jpraus/wirebender/stl/bender/Bender_MotorFrame.stl

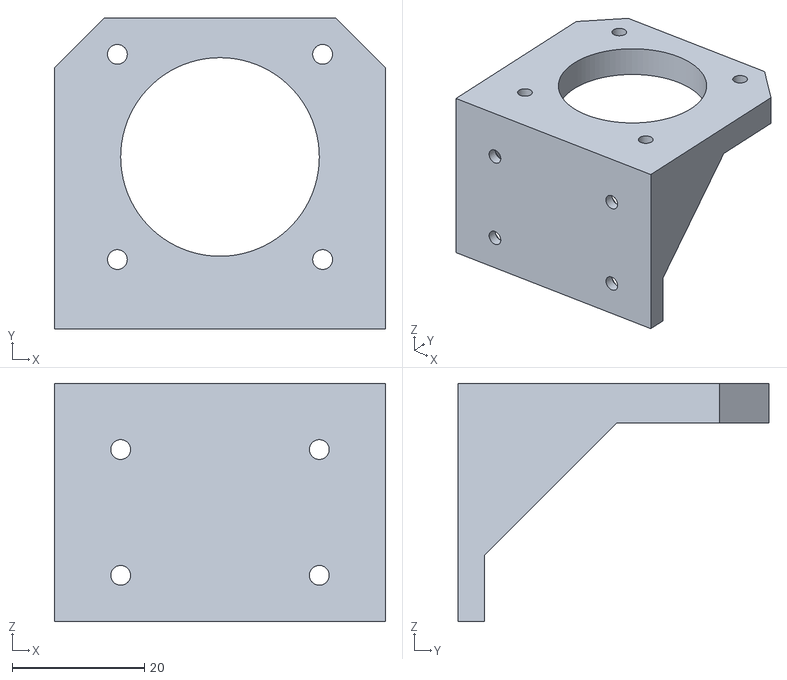
[picture p4: CAD file, 2019-07-29]
stl/bender/Bender_MotorFrame.stl
50.0 x 47.0 x 36.0
