jpraus/wirebender/stl/feeder/Feeder_IdlerGearSpacer.stl

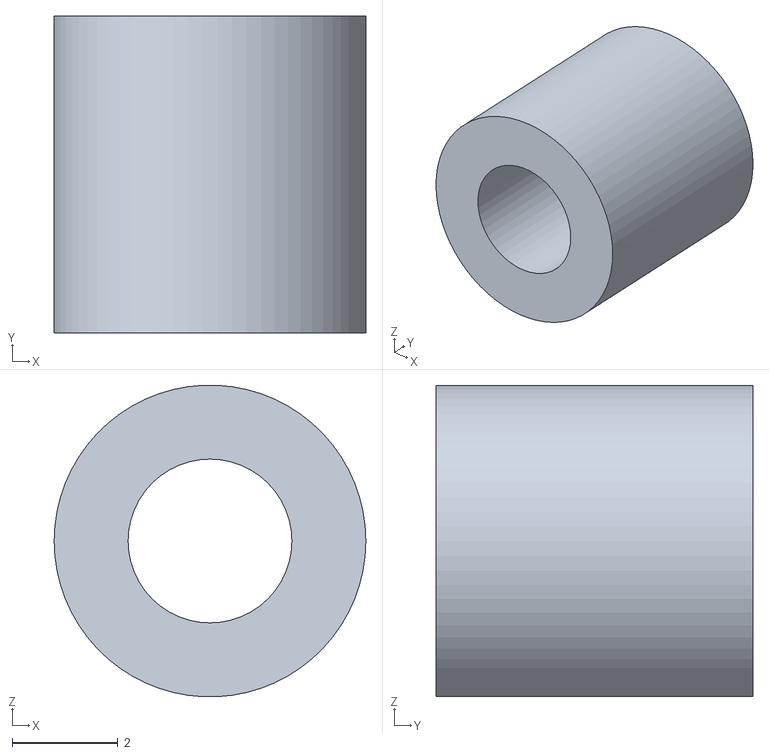
[picture p5: CAD file, 2019-12-29]
stl/feeder/Feeder_IdlerGearSpacer.stl
5.90 x 6.00 x 5.89
