jpraus/wirebender/stl/SpoolHolder.stl

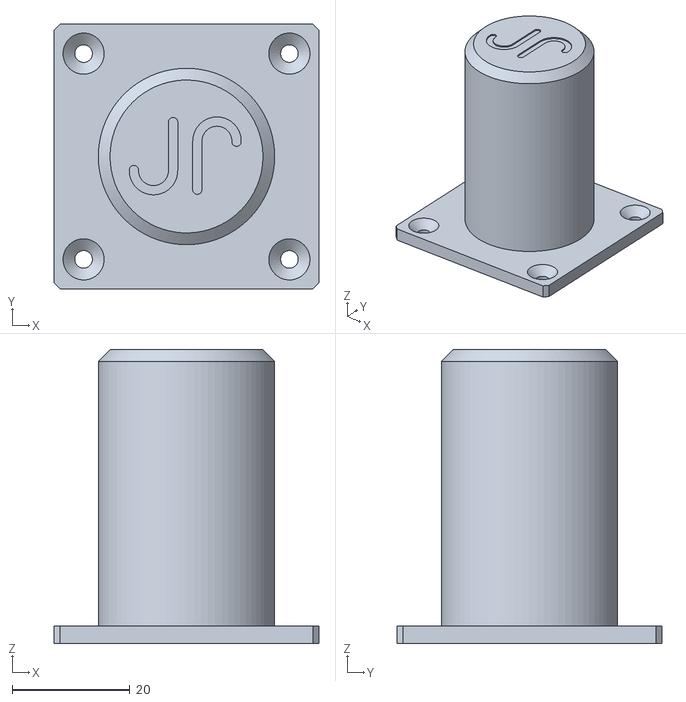
[picture p6: CAD file, 2019-07-14]
stl/SpoolHolder.stl
45.0 x 45.0 x 50.0
