jpraus/wirebender/stl/straightener/Straightener_Roller.stl

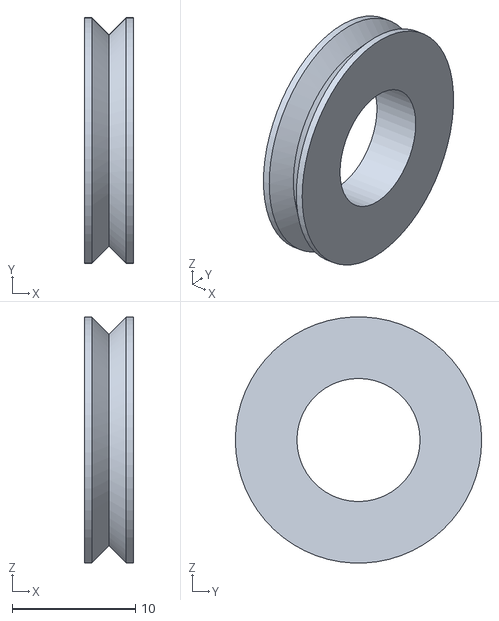
[picture p7: CAD file, 2019-09-25]
stl/straightener/Straightener_Roller.stl
4.00 x 20.0 x 20.0
