jpraus/wirebender/stl/bender/Bender_ToolHead.stl

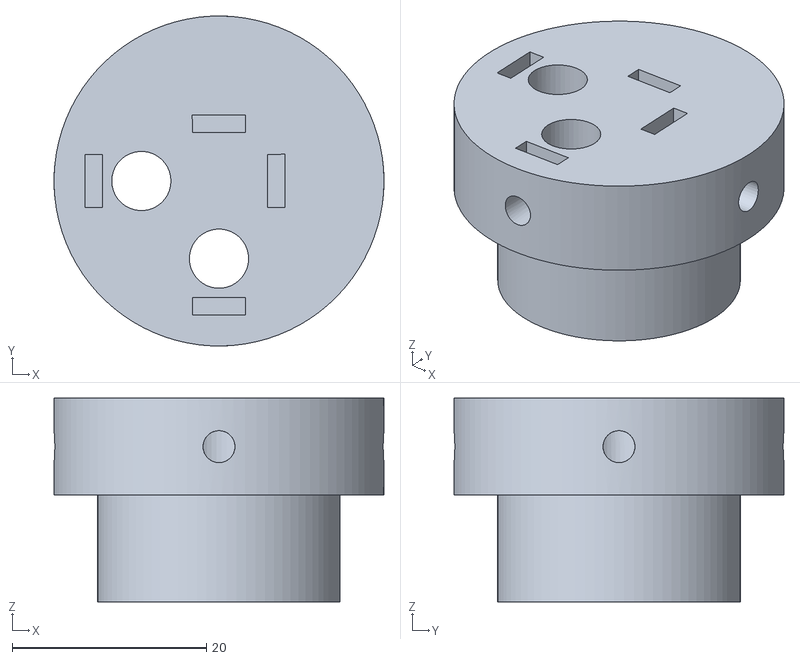
[picture p8: CAD file, 2019-07-14]
stl/bender/Bender_ToolHead.stl
34.0 x 34.0 x 21.0
