jpraus/wirebender/stl/feeder/Feeder_WireGuide.stl

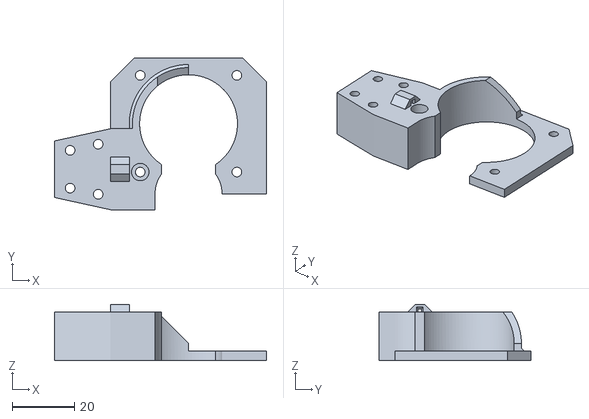
[picture p9: CAD file, 2019-07-14]
stl/feeder/Feeder_WireGuide.stl
68.0 x 48.6 x 18.0
