jpraus/wirebender/stl/straightener/Straightener_BedFrame.stl

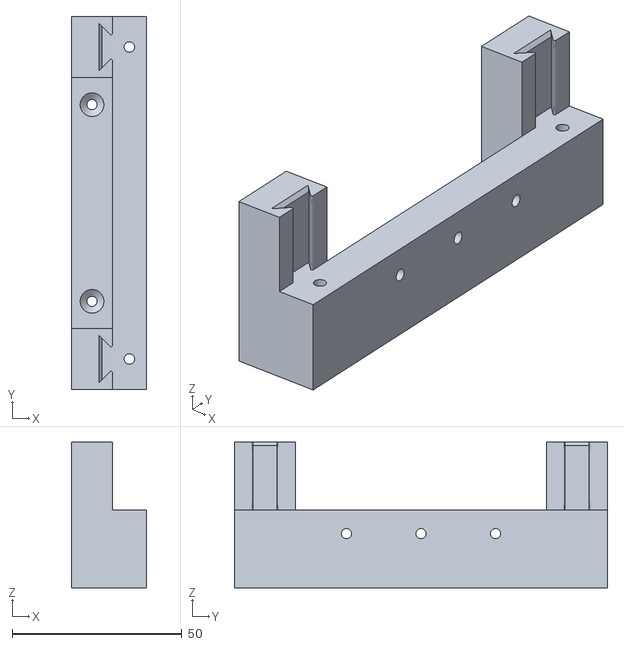
[picture p10: CAD file, 2019-09-25]
stl/straightener/Straightener_BedFrame.stl
22.0 x 110.0 x 43.0
