jpraus/wirebender/stl/feeder/Feeder_MotorFrame.stl

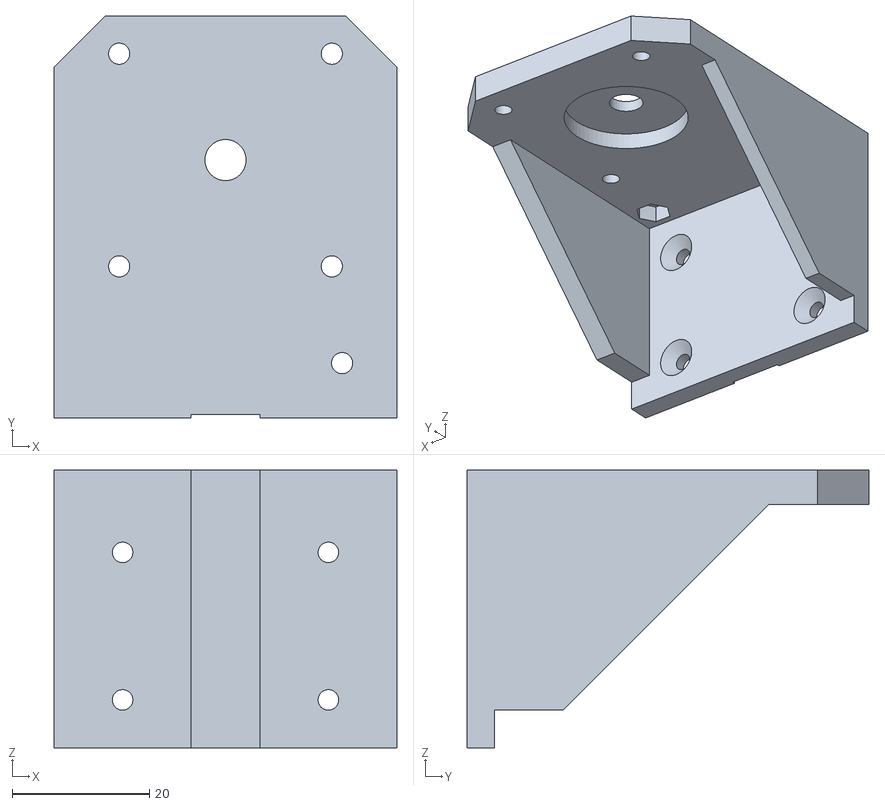
[picture p11: CAD file, 2019-07-14]
stl/feeder/Feeder_MotorFrame.stl
50.0 x 58.6 x 40.5
