jpraus/wirebender/stl/straightener/Straightener_TopFrame.stl

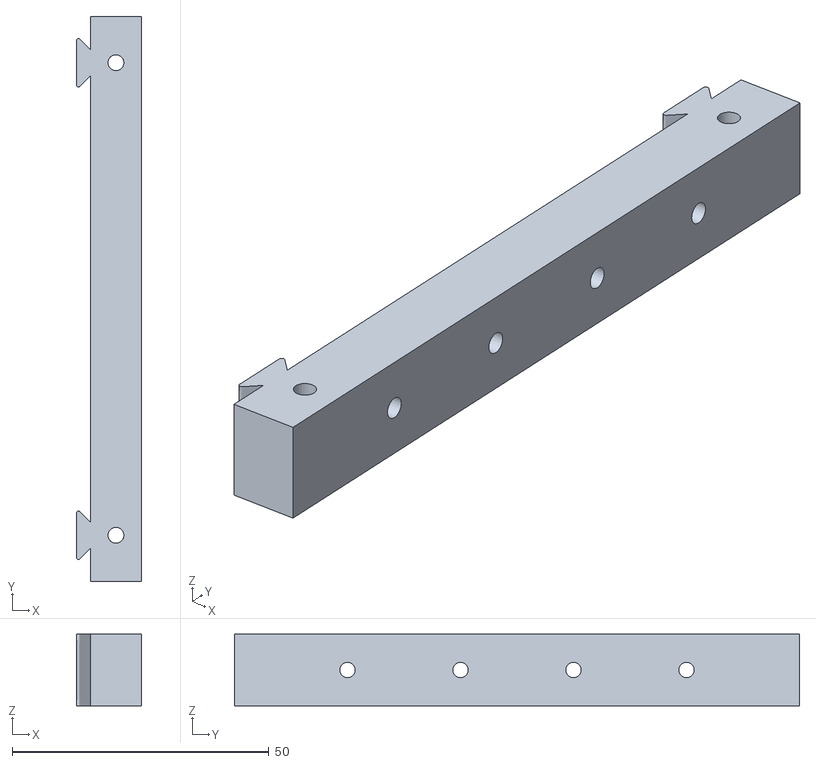
[picture p12: CAD file, 2019-09-25]
stl/straightener/Straightener_TopFrame.stl
12.7 x 110.0 x 14.0
