jpraus/wirebender/stl/feeder/Feeder_BottomFrame.stl

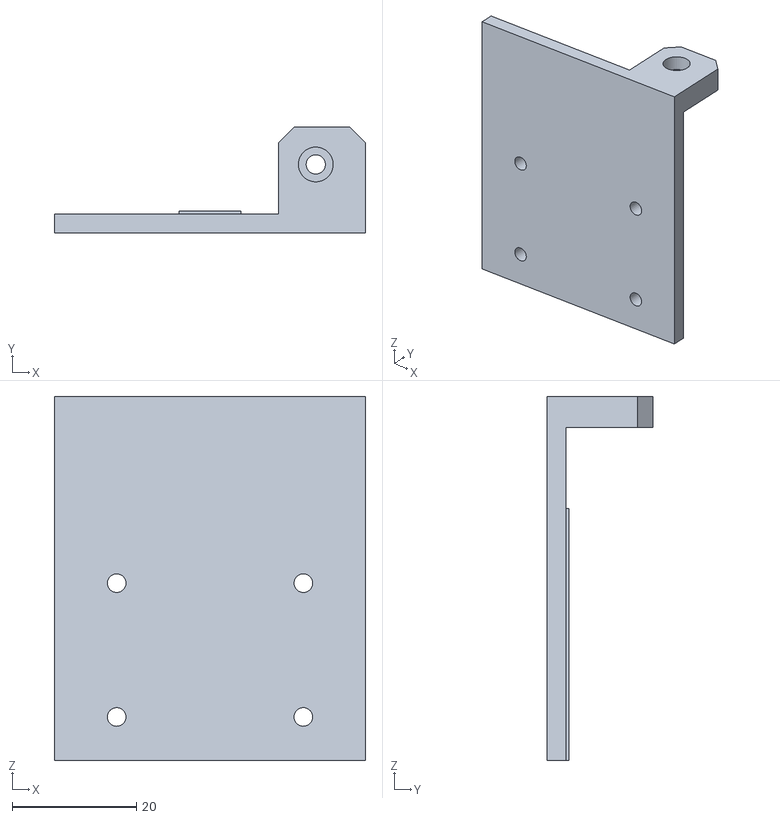
[picture p13: CAD file, 2019-07-14]
stl/feeder/Feeder_BottomFrame.stl
50.0 x 17.0 x 58.5
