jpraus/wirebender/stl/straightener/Straightener_RollerNoBearing.stl

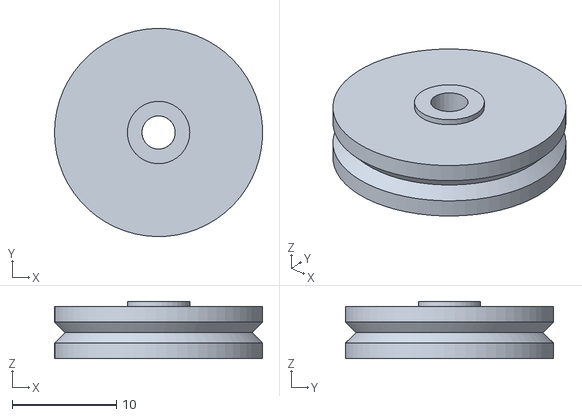
[picture p14: CAD file, 2019-07-29]
stl/straightener/Straightener_RollerNoBearing.stl
20.0 x 20.0 x 5.50
