jpraus/wirebender/stl/feeder/Feeder_BendingPlateTemplate.stl

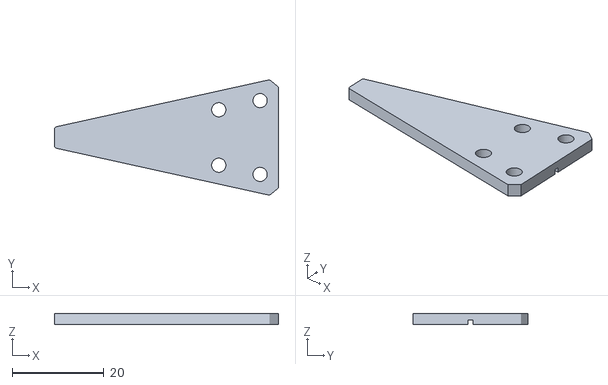
[picture p15: CAD file, 2019-07-14]
stl/feeder/Feeder_BendingPlateTemplate.stl
48.8 x 25.1 x 2.50
