jpraus/wirebender/stl/feeder/Feeder_IdlerGearCarriage.stl

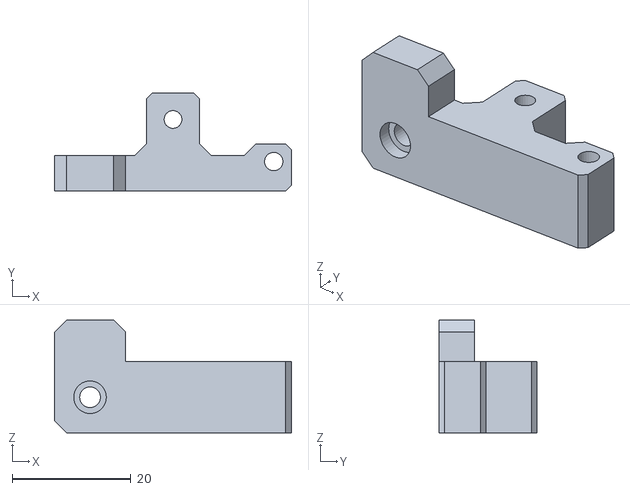
[picture p16: CAD file, 2019-07-14]
stl/feeder/Feeder_IdlerGearCarriage.stl
40.0 x 16.6 x 19.0
