jpraus/wirebender/stl/feeder/Feeder_FeedingGearSpacer.stl

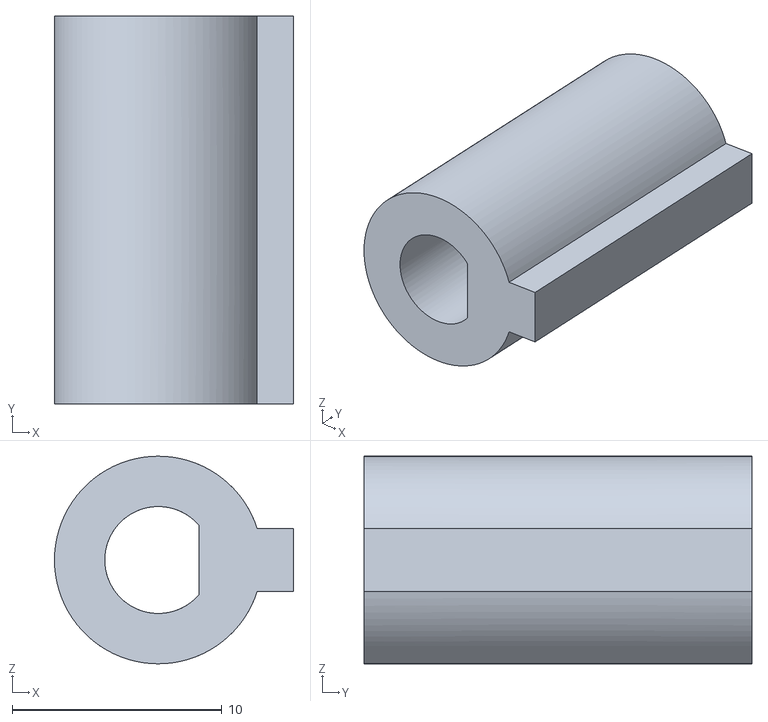
[picture p17: CAD file, 2019-07-14]
stl/feeder/Feeder_FeedingGearSpacer.stl
11.4 x 18.5 x 9.90
