jpraus/wirebender/(threads)

Thread 1 (2019-09-11):

Part list share

dcast78, 2019-09-11:
Hi, there,
can you please share the list of non-printing parts?
For example, bearings, metal parts of the feeder.
Thank you

xlogik, 2019-11-09:
@dcast78 The project can be found at https://www.instructables.com/id/Spring-Making-Wire-Bending-Machine/

dcast78, 2019-11-09:
Great!

Thread 4 (2023-12-06):

[Feature suggestion] Straightener only works on one plane

somekid6, 2023-12-06:
It might be beneficial to lay one of the roller assemblies on it's back to straighten on another plane. Premade assemblies ([example](https://www.amazon.com/LeTkingok-Wire-and-Cable-Straightener/dp/B09C5RWY1S)) have the rollers rotated for that.

[image](https://github.com/jpraus/wirebender/assets/53590807/218f179f-2d3b-4557-9060-faafadc17b28)

ProBackup-nl, 2024-03-14:
@somekid6 The [njmcpherson short dual plane 3/16" straightener](https://www.thingiverse.com/thing:4754659) can scaled down and FDM printed. At 53% scaling, wire diameter 2.5 mm, this printable wire straightner is near M4 size for mounting the bearings.
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
