jpraus/wirebender/(commit log)

2019-07-14 V3 stl files and doc images
    [Bender_ToolHead.stl, DriveGear_Center.stl, DriveGear_CenterSquare.stl, Extruder_BendPlate.stl, Extruder_BottomFrame.stl, Extruder_DriveGearCarriage.stl, Extruder_MotorFrame.stl, Extruder_WireGuide.stl]
2019-07-29 All STL files for version 1.0
    [Bender_Head.stl, Bender_MotorFrame.stl, DriveGear_CenterSquare.stl, Feeder_BendingPlateTemplate.stl, Feeder_BendingSupport.stl, Feeder_BottomFrame.stl, Feeder_GearSpacer.stl, Feeder_IdlerCarriage.stl]
2019-09-25 latest STL files
    [Bender_ToolHead.stl, Feeder_FeedingGearSpacer.stl, Feeder_IdlerGearCarriage.stl, Feeder_WireGuide.stl, Straightener_BedFrame.stl, Straightener_GearsFrame.stl, Straightener_HorizontalBed.stl, Straightener_Roller.stl]
2019-12-29 Added missing idler gear spacer
    [Feeder_IdlerGearSpacer.stl]
